RoboticArts/Analizador-de-audio-con-arduino/README.md

# Analizador-de-audio-con-arduino
Sonómetro de decibelios y analizador de espectro FFT con pantalla  TFT y preamplificador de micrófono para Arduino UNO en formato shield.

En el pdf Anlizador de Audio Documentación encontrarás información adicional al vídeo: https://youtu.be/dKPURQHRQ4k

Librerías necesarias para compilar el programa

Librería TFT: https://github.com/adafruit/TFTLCD-Library

Librería de gráficos: https://github.com/adafruit/Adafruit-GFX-Library

Librería FHT: http://wiki.openmusiclabs.com/wiki/ArduinoFHT?action=AttachFile&do=view&target=ArduinoFHT4.zip

También puedes bajarte desde las tres a la vez. Descomprime el archivo y mueve las librerías en Documetos - Arduino - Librerias:
http://www.mediafire.com/file/38qfa94b6bpywek/Librerias_Pack.rar

Circuito easyEDA modificable: https://easyeda.com/roboticarts1/Proyectos-d16de7d5fcc04d69acaac639ba3e3e64
