RoboticArts/Analizador-de-audio-con-arduino/AudioAnalyzerSilk.pdf

R3 81 GND 82 2
